absmach/s0/modules/wmbus/wmbus.kicad_pcb

## KiCad design modules/wmbus/wmbus.kicad_pcb (2026-07-27)

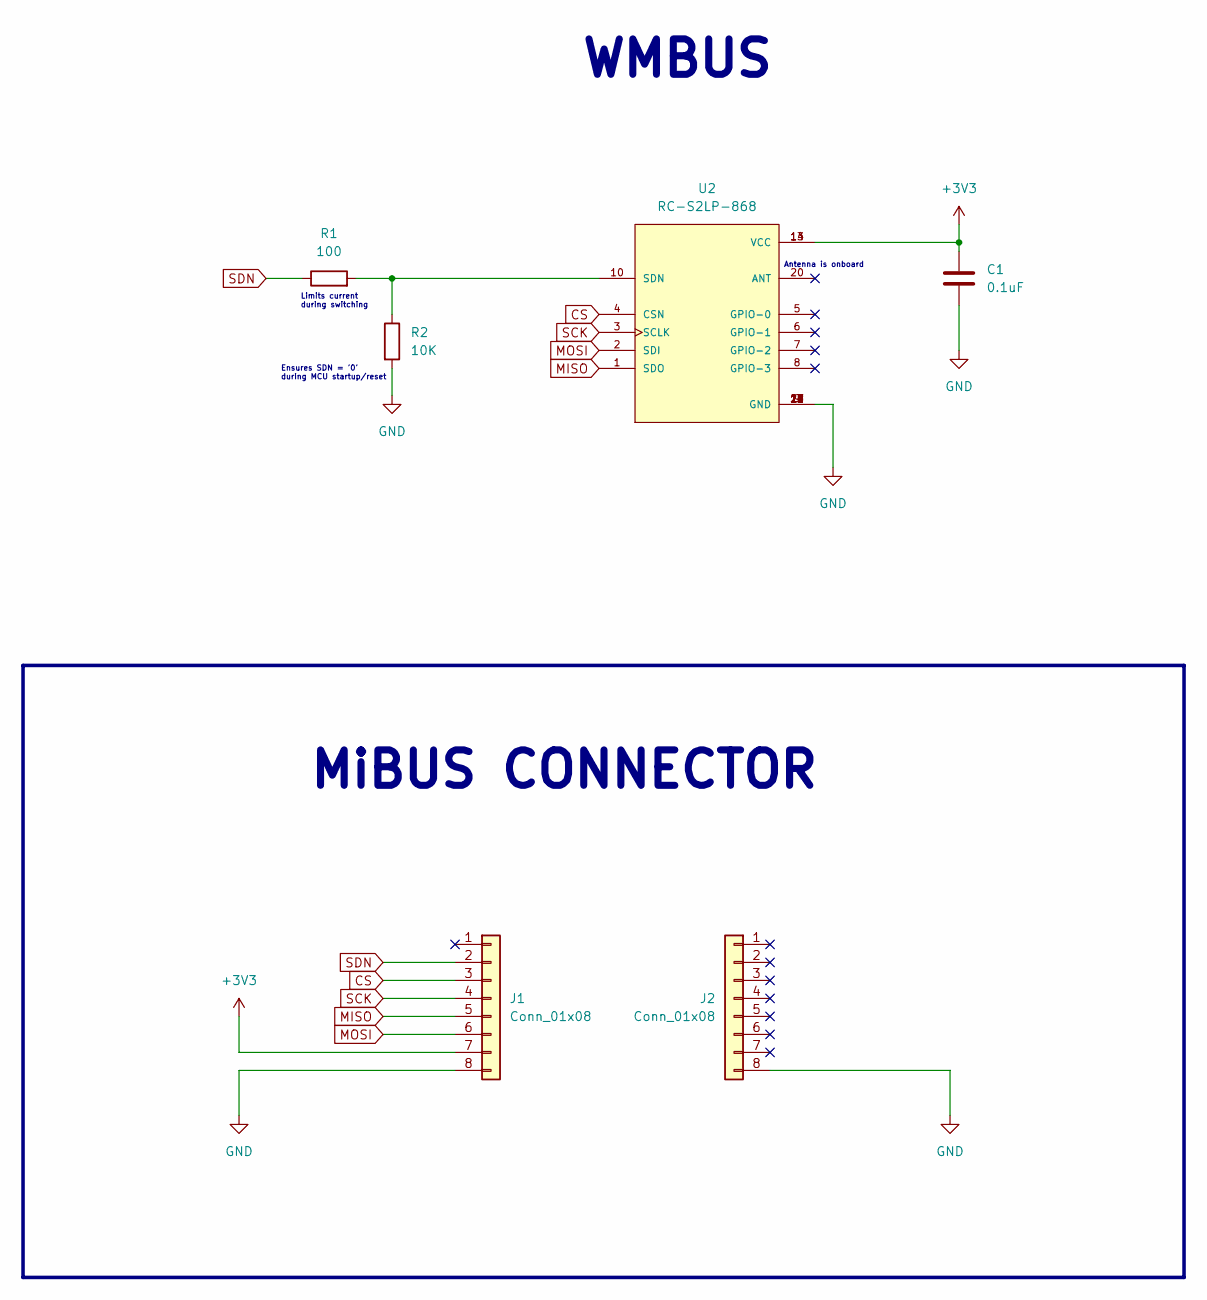
[picture p1: schematic wmbus.kicad_sch, A0 - WMBUS Module]

Parts:
C1: 0.1uF; C_0805_2012Metric; JLCPCB C49678
J1, J2: Conn_01x08; PinHeader_1x08_P2.54mm_Vertical; JLCPCB C492407
R1: 100; R_0805_2012Metric; JLCPCB C17408
R2: 10K; R_0805_2012Metric; JLCPCB C17414
U2: RC-S2LP-868; PARTREV 1.6; DigiKey_Part_Number 3206-RC-S2LP-868TR-ND

Connections:
+3V3: C1.1, J1.7, U2.13 (VCC), U2.14 (VCC)
CS: J1.3, U2.4 (CSN)
GND: C1.2, J1.8, J2.8, R2.2, U2.9 (GND), U2.11 (GND), U2.12 (GND), U2.15 (GND), U2.16 (GND), U2.17 (GND), U2.18 (GND), U2.19 (GND), U2.21 (GND)
MISO: J1.5, U2.1 (SDO)
MOSI: J1.6, U2.2 (SDI)
unnamed: R1.2, R2.1, U2.10 (SDN)
SCK: J1.4, U2.3 (SCLK)
SDN: J1.2, R1.1

Notes on the sheet:
WMBUS
Ensures SDN = '0' during MCU startup/reset
MiBUS CONNECTOR
Limits current during switching
Antenna is onboard

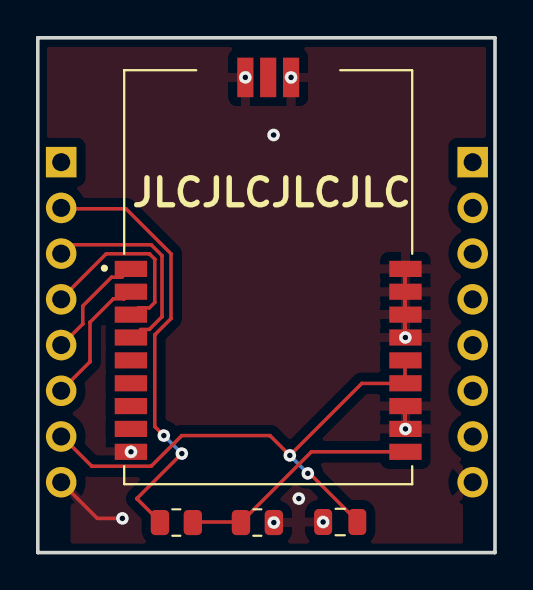
[picture p2: board wmbus.kicad_pcb from above]

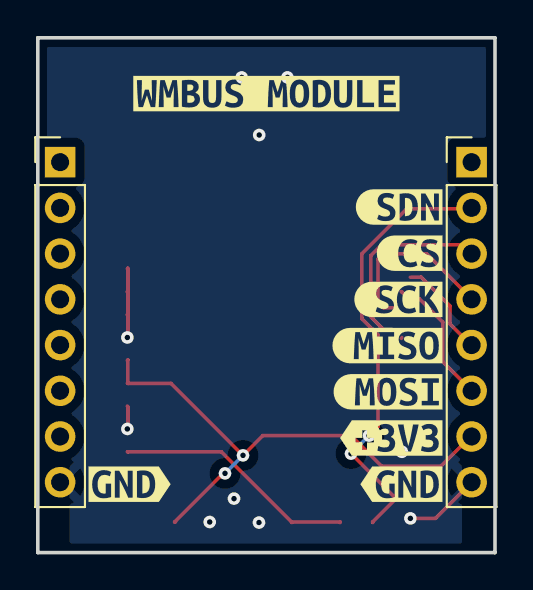
[picture p3: board wmbus.kicad_pcb from below]

Board: 2 copper layers, 25.4 x 28.6 mm, 15 parts (11 on the bottom side), 8 nets.

Other parts of the board:
kibuzzard-6A563B7D: G***; kibuzzard-6A563B7D
kibuzzard-6A563B31: G***; kibuzzard-6A563B31
kibuzzard-6A563B41: G***; kibuzzard-6A563B41
kibuzzard-6A563B50: G***; kibuzzard-6A563B50
kibuzzard-6A563B65: G***; kibuzzard-6A563B65
kibuzzard-6A563B71: G***; kibuzzard-6A563B71
kibuzzard-6A563B88: G***; kibuzzard-6A563B88
kibuzzard-6A563B96: G***; kibuzzard-6A563B96
kibuzzard-6A563BEF: G***; kibuzzard-6A563BEF
