absmach/s0/modules/sim7080g/sim7080g.kicad_pcb

## KiCad design modules/sim7080g/sim7080g.kicad_pcb (2026-07-27)

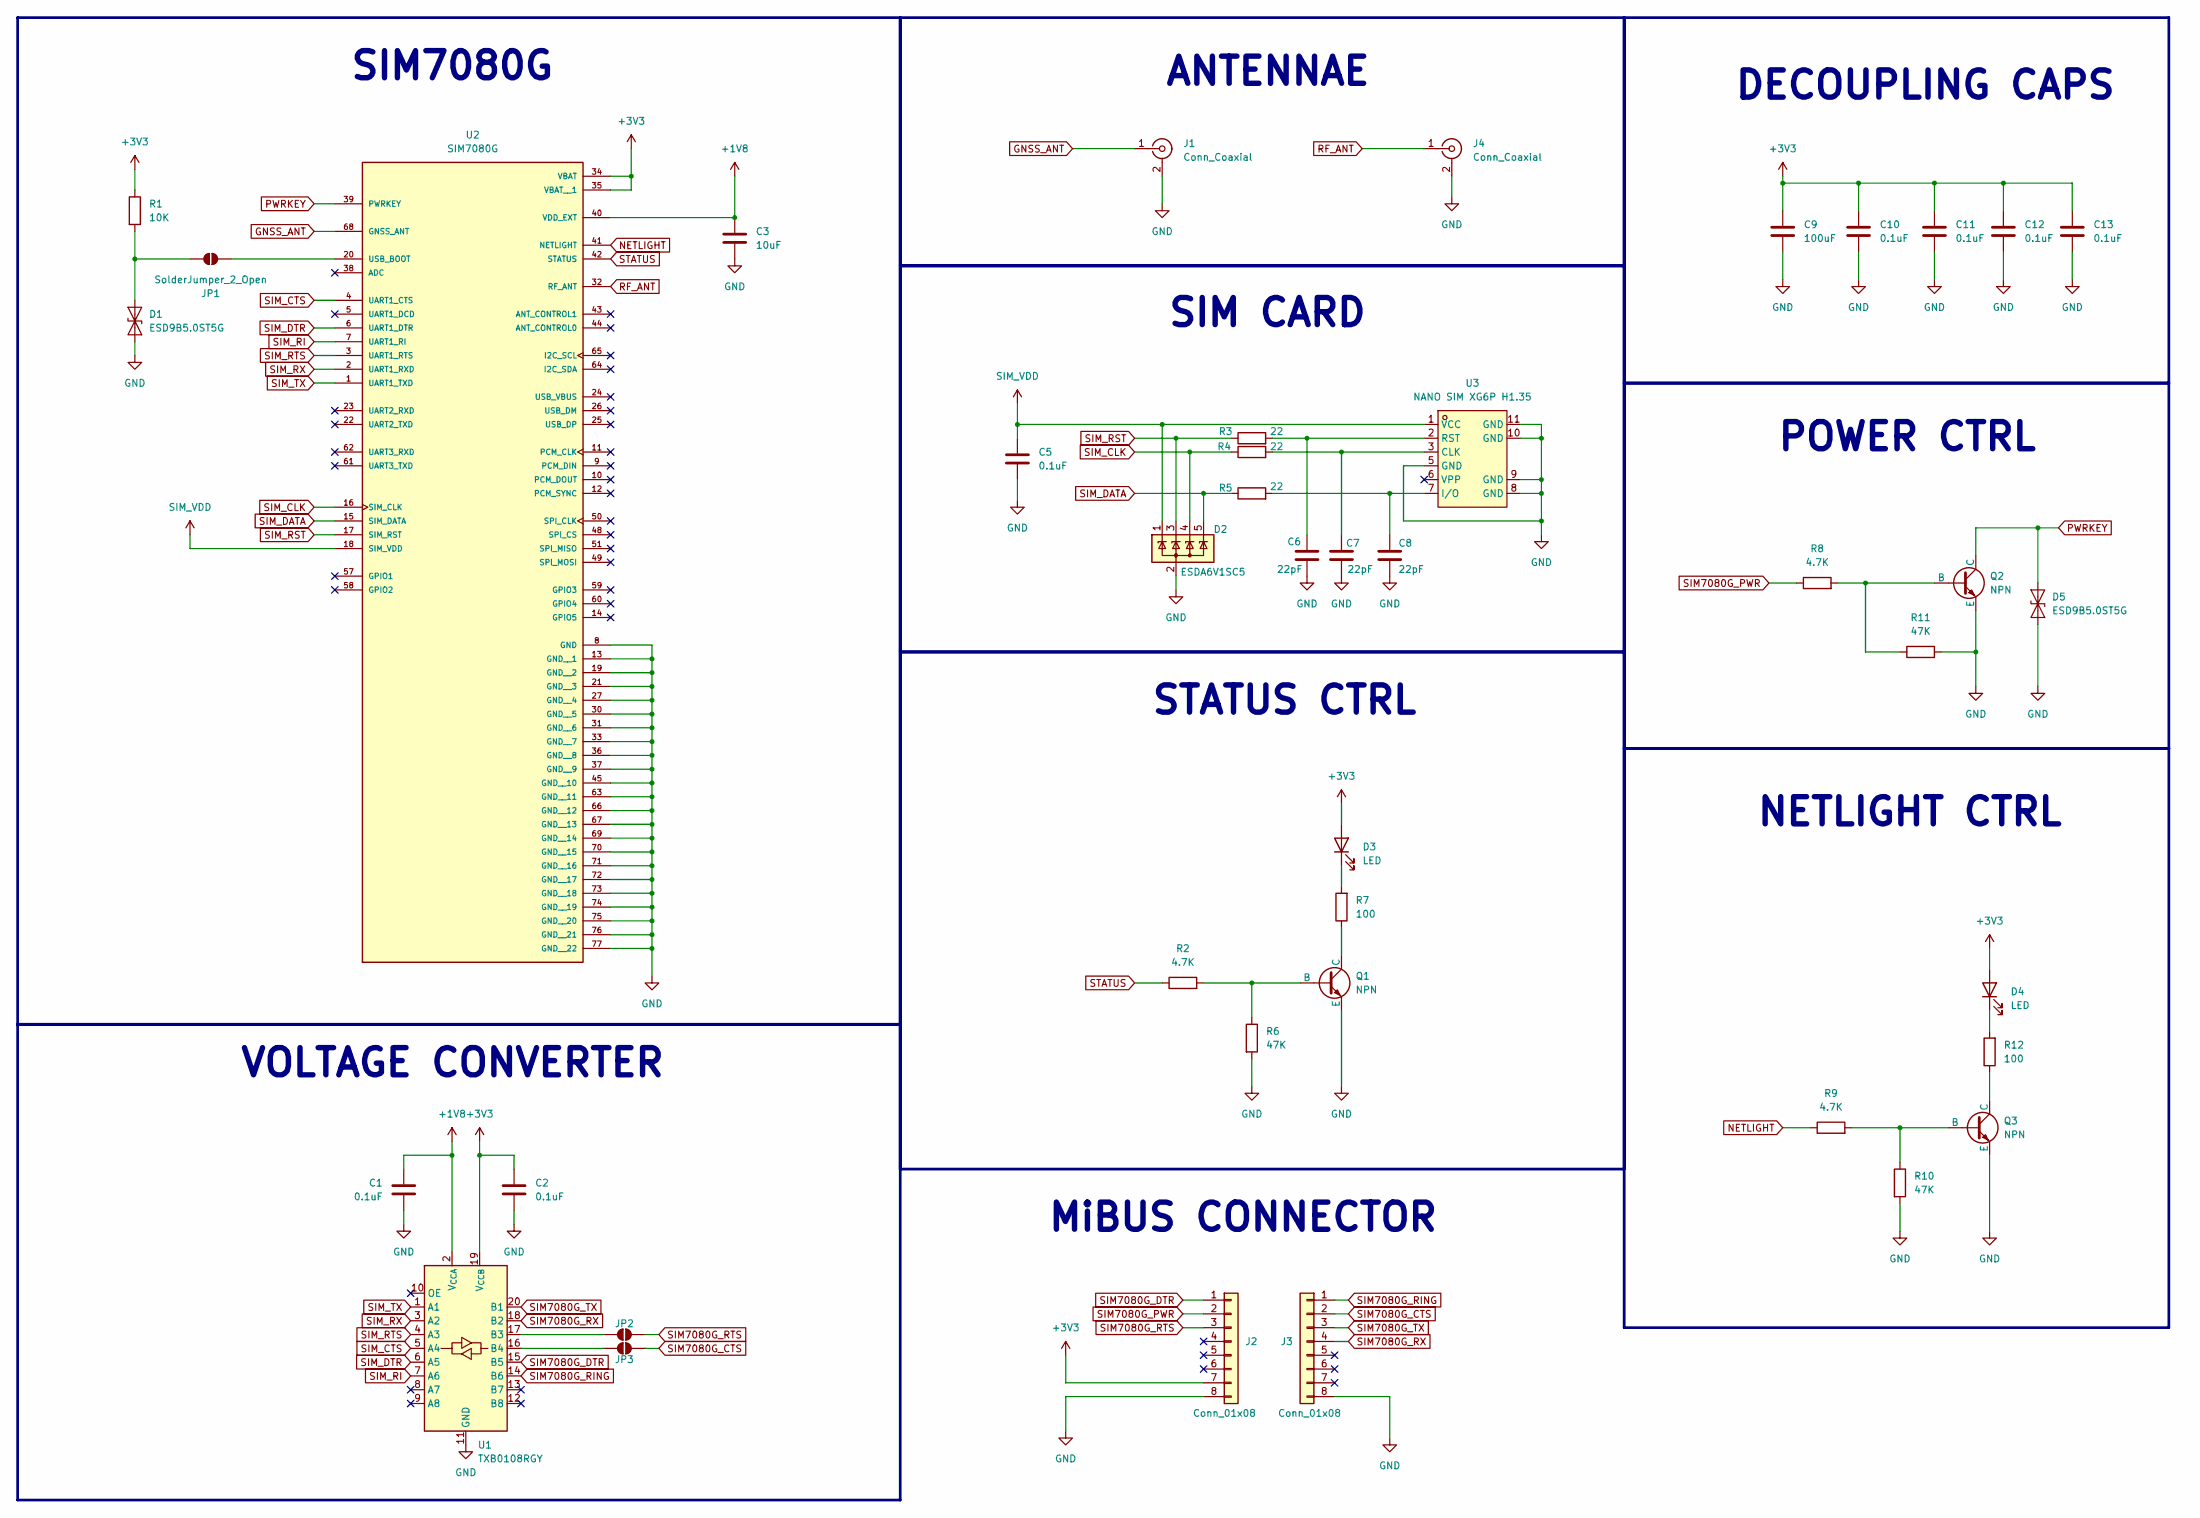
[picture p4: schematic sim7080g.kicad_sch, A0 - SIM7080G Module]

Parts:
C1, C2, C5, C10, C11, C12, C13: 0.1uF; C_0805_2012Metric; JLCPCB C49678
C3: 10uF; C_0805_2012Metric; JLCPCB C15850
C6, C7, C8: 22pF; C_0805_2012Metric; JLCPCB C1804
C9: 100uF; C_1206_3216Metric; JLCPCB C15008
D1, D5: ESD9B5.0ST5G; D_SOD-923; JLCPCB C111566
D2: ESDA6V1SC5; SOT-23-5; JLCPCB C2935146
D3, D4: LED; LED_0805_2012Metric; JLCPCB C6848499
J1, J4: Conn_Coaxial; U.FL_Hirose_U.FL-R-SMT-1_Vertical; JLCPCB C88373
J2, J3: Conn_01x08; PinHeader_1x08_P2.54mm_Vertical; JLCPCB C492407
JP1, JP2, JP3: SolderJumper_2_Open; SolderJumper-2_P1.3mm_Open_RoundedPad1.0x1.5mm
Q1, Q2, Q3: NPN; SOT-23; JLCPCB C2150
R1: 10K; R_0805_2012Metric; JLCPCB C17414
R2, R8, R9: 4.7K; R_0805_2012Metric; JLCPCB C17673
R3, R4, R5: 22; R_0805_2012Metric; JLCPCB C17561
R6, R10, R11: 47K; R_0805_2012Metric; JLCPCB C17713
R7, R12: 100; R_0805_2012Metric; JLCPCB C17408
U1: TXB0108RGY; Texas_RGY_R-PVQFN-N20_EP2.05x3.05mm; JLCPCB C194701
U2: SIM7080G; PARTREV 1.04; JLCPCB C2943992
U3: NANO SIM XG6P H1.35; SIM-SMD_NANO-SIM; LCSC Part C7529386

Connections:
+1V8: C1.2, C3.2, U1.2 (V_{CCA}), U2.40 (VDD_EXT)
+3V3: C2.2, C9.1, C10.1, C11.1, C12.1, C13.1, D3.2 (A), D4.2 (A), J2.7, R1.1, U1.19 (V_{CCB}), U2.34 (VBAT), U2.35 (VBAT__1)
GND: C1.1, C2.1, C3.1, C5.1, C6.1, C7.1, C8.1, C9.2, C10.2, C11.2, C12.2, C13.2, D1.1 (A1), D2.2 (A), D5.1 (A1), J1.2 (Ext), J2.8, J3.8, J4.2 (Ext), Q1.3 (E), Q2.3 (E), Q3.3 (E), R6.2, R10.2, R11.2, U1.11 (GND), U1.21 (GND), U2.8 (GND), U2.13 (GND__1), U2.19 (GND__2), U2.21 (GND__3), U2.27 (GND__4), U2.30 (GND__5), U2.31 (GND__6), U2.33 (GND__7), U2.36 (GND__8), U2.37 (GND__9), U2.45 (GND__10), U2.63 (GND__11), U2.66 (GND__12), U2.67 (GND__13), U2.69 (GND__14), U2.70 (GND__15), U2.71 (GND__16), U2.72 (GND__17), U2.73 (GND__18), U2.74 (GND__19), U2.75 (GND__20), U2.76 (GND__21), U2.77 (GND__22), U3.5 (GND), U3.8 (GND), U3.9 (GND), U3.10 (GND), U3.11 (GND)
GNSS_ANT: J1.1 (In), U2.68 (GNSS_ANT)
NETLIGHT: R9.1, U2.41 (NETLIGHT)
unnamed: D1.2 (A2), JP1.1 (A), R1.2
unnamed: D3.1 (K), R7.2
unnamed: D4.1 (K), R12.2
unnamed: JP1.2 (B), U2.20 (USB_BOOT)
unnamed: JP2.1 (A), U1.17 (B3)
unnamed: JP3.1 (A), U1.16 (B4)
unnamed: Q1.2 (B), R2.2, R6.1
unnamed: Q1.1 (C), R7.1
unnamed: Q2.2 (B), R8.2, R11.1
unnamed: Q3.2 (B), R9.2, R10.1
unnamed: Q3.1 (C), R12.1
unnamed: C7.2, R4.2, U3.3 (CLK)
unnamed: C8.2, R5.2, U3.7 (I/O)
unnamed: C6.2, R3.2, U3.2 (RST)
PWRKEY: D5.2 (A2), Q2.1 (C), U2.39 (PWRKEY)
RF_ANT: J4.1 (In), U2.32 (RF_ANT)
SIM7080G_CTS: J3.2, JP3.2 (B)
SIM7080G_DTR: J2.1, U1.15 (B5)
SIM7080G_PWR: J2.2, R8.1
SIM7080G_RING: J3.1, U1.14 (B6)
SIM7080G_RTS: J2.3, JP2.2 (B)
SIM7080G_RX: J3.4, U1.18 (B2)
SIM7080G_TX: J3.3, U1.20 (B1)
SIM_CLK: D2.4 (K), R4.1, U2.16 (SIM_CLK)
SIM_CTS: U1.5 (A4), U2.4 (UART1_CTS)
SIM_DATA: D2.5 (K), R5.1, U2.15 (SIM_DATA)
SIM_DTR: U1.6 (A5), U2.6 (UART1_DTR)
SIM_RI: U1.7 (A6), U2.7 (UART1_RI)
SIM_RST: D2.3 (K), R3.1, U2.17 (SIM_RST)
SIM_RTS: U1.4 (A3), U2.3 (UART1_RTS)
SIM_RX: U1.3 (A2), U2.2 (UART1_RXD)
SIM_TX: U1.1 (A1), U2.1 (UART1_TXD)
SIM_VDD: C5.2, D2.1 (K), U2.18 (SIM_VDD), U3.1 (VCC)
STATUS: R2.1, U2.42 (STATUS)

Notes on the sheet:
MiBUS CONNECTOR
SIM CARD
DECOUPLING CAPS
POWER CTRL
SIM7080G
VOLTAGE CONVERTER
ANTENNAE
STATUS CTRL
NETLIGHT CTRL

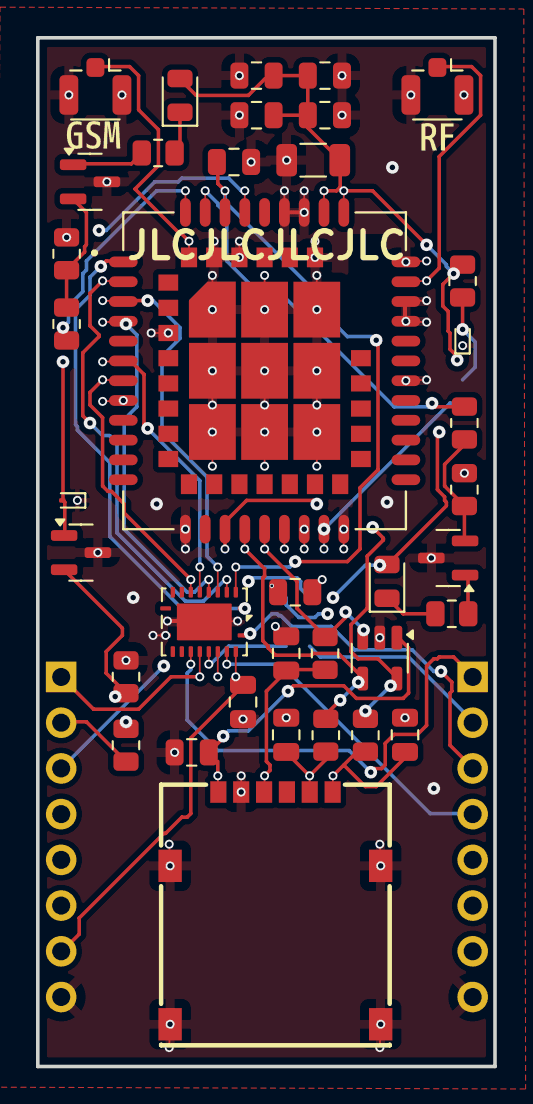
[picture p5: board sim7080g.kicad_pcb from above]

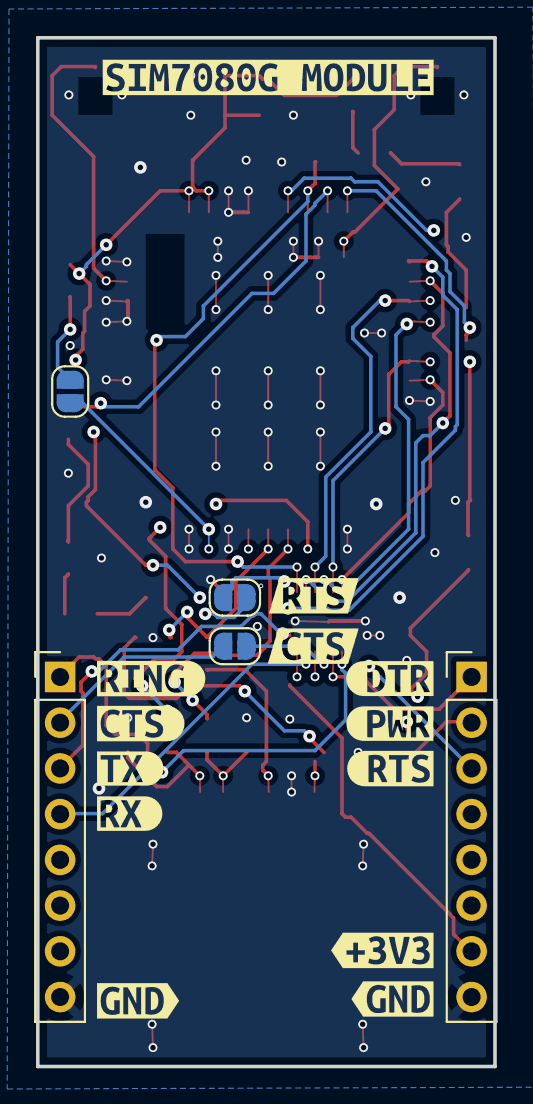
[picture p6: board sim7080g.kicad_pcb from below]

Board: 4 copper layers, 25.4 x 57.2 mm, 57 parts (18 on the bottom side), 39 nets.

Other parts of the board:
kibuzzard-6A58AA2C: G***; kibuzzard-6A58AA2C
kibuzzard-6A58AA08: G***; kibuzzard-6A58AA08
kibuzzard-6A58AA80: G***; kibuzzard-6A58AA80
kibuzzard-6A58AA90: G***; kibuzzard-6A58AA90
kibuzzard-6A58AAA8: G***; kibuzzard-6A58AAA8
kibuzzard-6A58AAC0: G***; kibuzzard-6A58AAC0
kibuzzard-6A58AAD1: G***; kibuzzard-6A58AAD1
kibuzzard-6A58ABB3: G***; kibuzzard-6A58ABB3
kibuzzard-6A58ABC2: G***; kibuzzard-6A58ABC2
kibuzzard-6A58ABCC: G***; kibuzzard-6A58ABCC
kibuzzard-6A58ABD9: G***; kibuzzard-6A58ABD9
kibuzzard-6A58ABE5: G***; kibuzzard-6A58ABE5
kibuzzard-6A58AD62: G***; kibuzzard-6A58AD62
kibuzzard-6A58AD87: G***; kibuzzard-6A58AD87
kibuzzard-6A58ADF5: G***; kibuzzard-6A58ADF5
