absmach/s0/modules/E07400M10S/E07400M10S.kicad_pcb

## KiCad design modules/E07400M10S/E07400M10S.kicad_pcb (2026-07-27)

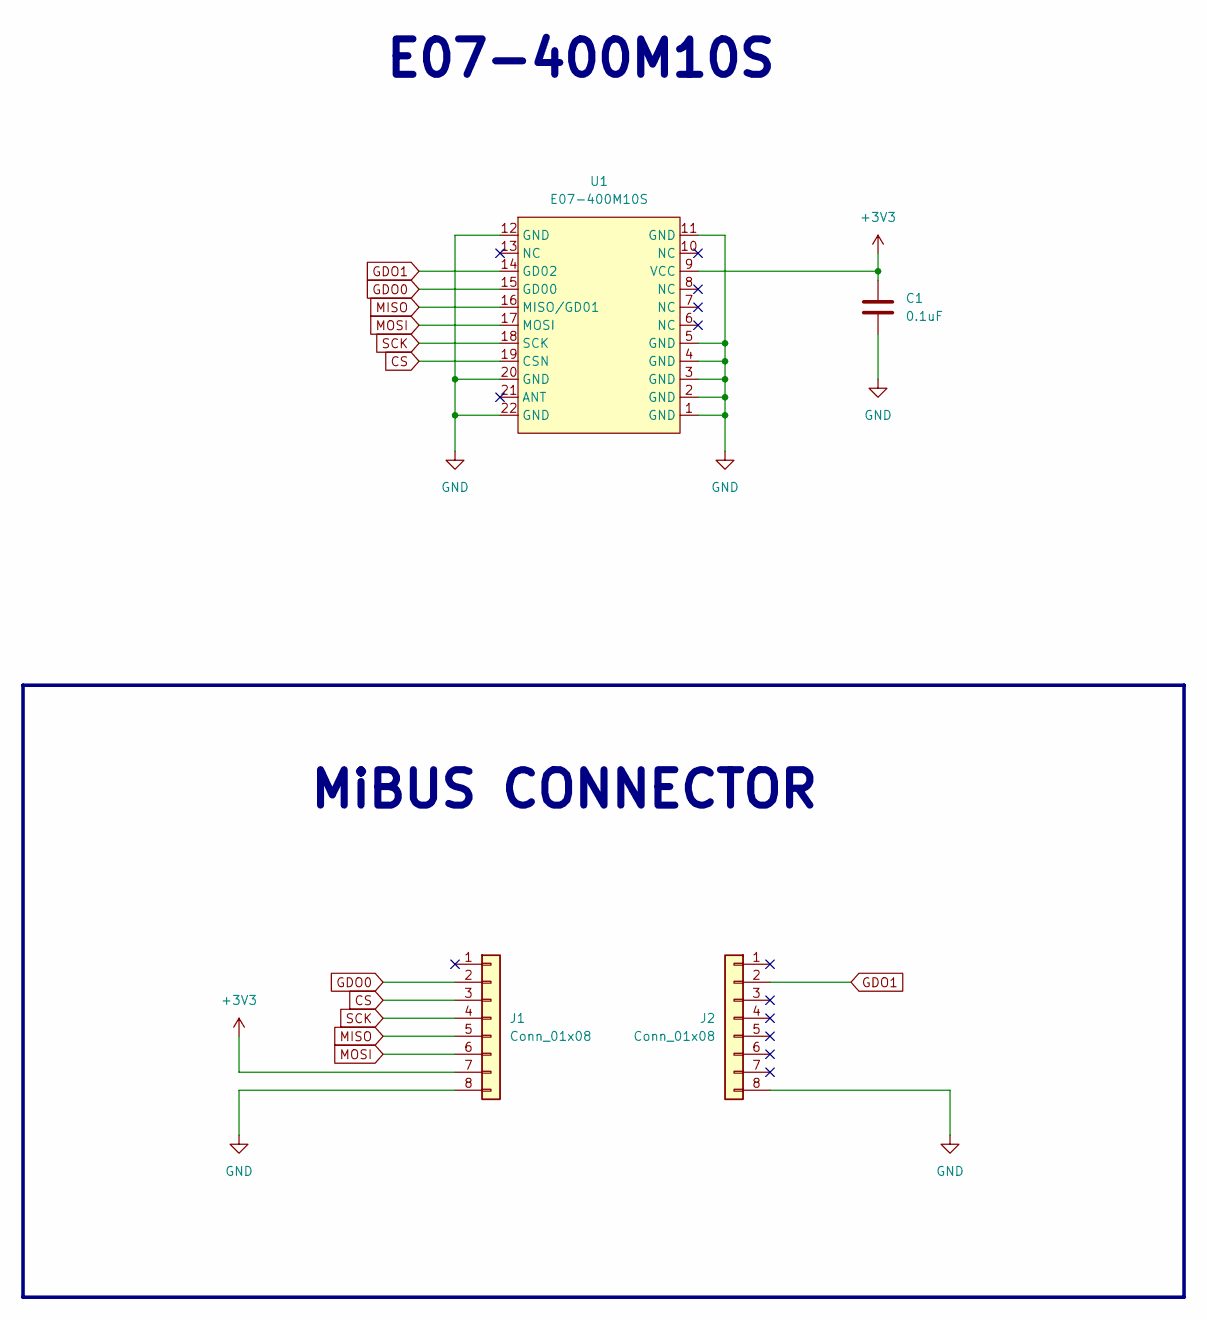
[picture p7: schematic E07400M10S.kicad_sch, A0 - E07-400M10S Module]

Parts:
C1: 0.1uF; C_0805_2012Metric; JLCPCB C49678
J1, J2: Conn_01x08; PinHeader_1x08_P2.54mm_Vertical; JLCPCB C492407
U1: E07-400M10S; C2965513; MPN E07-400M10S; LCSC Part C2965513

Connections:
+3V3: C1.1, J1.7, U1.9 (VCC)
CS: J1.3, U1.19 (CSN)
GDO0: J1.2, U1.15 (GD00)
GDO1: J2.2, U1.14 (GD02)
GND: C1.2, J1.8, J2.8, U1.1 (GND), U1.2 (GND), U1.3 (GND), U1.4 (GND), U1.5 (GND), U1.11 (GND), U1.12 (GND), U1.20 (GND), U1.22 (GND)
MISO: J1.5, U1.16 (MISO/GD01)
MOSI: J1.6, U1.17 (MOSI)
SCK: J1.4, U1.18 (SCK)

Notes on the sheet:
E07-400M10S
MiBUS CONNECTOR

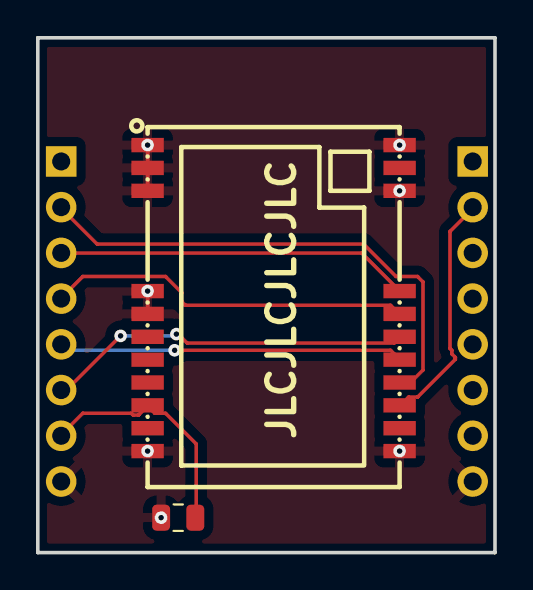
[picture p8: board E07400M10S.kicad_pcb from above]

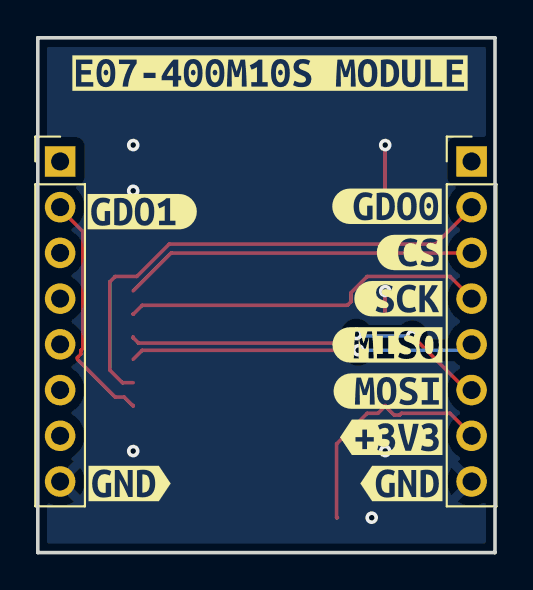
[picture p9: board E07400M10S.kicad_pcb from below]

Board: 2 copper layers, 25.4 x 28.6 mm, 14 parts (12 on the bottom side), 8 nets.

Other parts of the board:
kibuzzard-6A5A4D23: G***; kibuzzard-6A5A4D23
kibuzzard-6A5A4D79: G***; kibuzzard-6A5A4D79
kibuzzard-6A5A4D90: G***; kibuzzard-6A5A4D90
kibuzzard-6A563B7D: G***; kibuzzard-6A563B7D
kibuzzard-6A563B41: G***; kibuzzard-6A563B41
kibuzzard-6A563B50: G***; kibuzzard-6A563B50
kibuzzard-6A563B65: G***; kibuzzard-6A563B65
kibuzzard-6A563B71: G***; kibuzzard-6A563B71
kibuzzard-6A563B88: G***; kibuzzard-6A563B88
kibuzzard-6A563B96: G***; kibuzzard-6A563B96
