absmach/s0/a0-base-board/a0-base-board.kicad_pcb

## KiCad design a0-base-board/a0-base-board.kicad_pcb (2026-07-06)

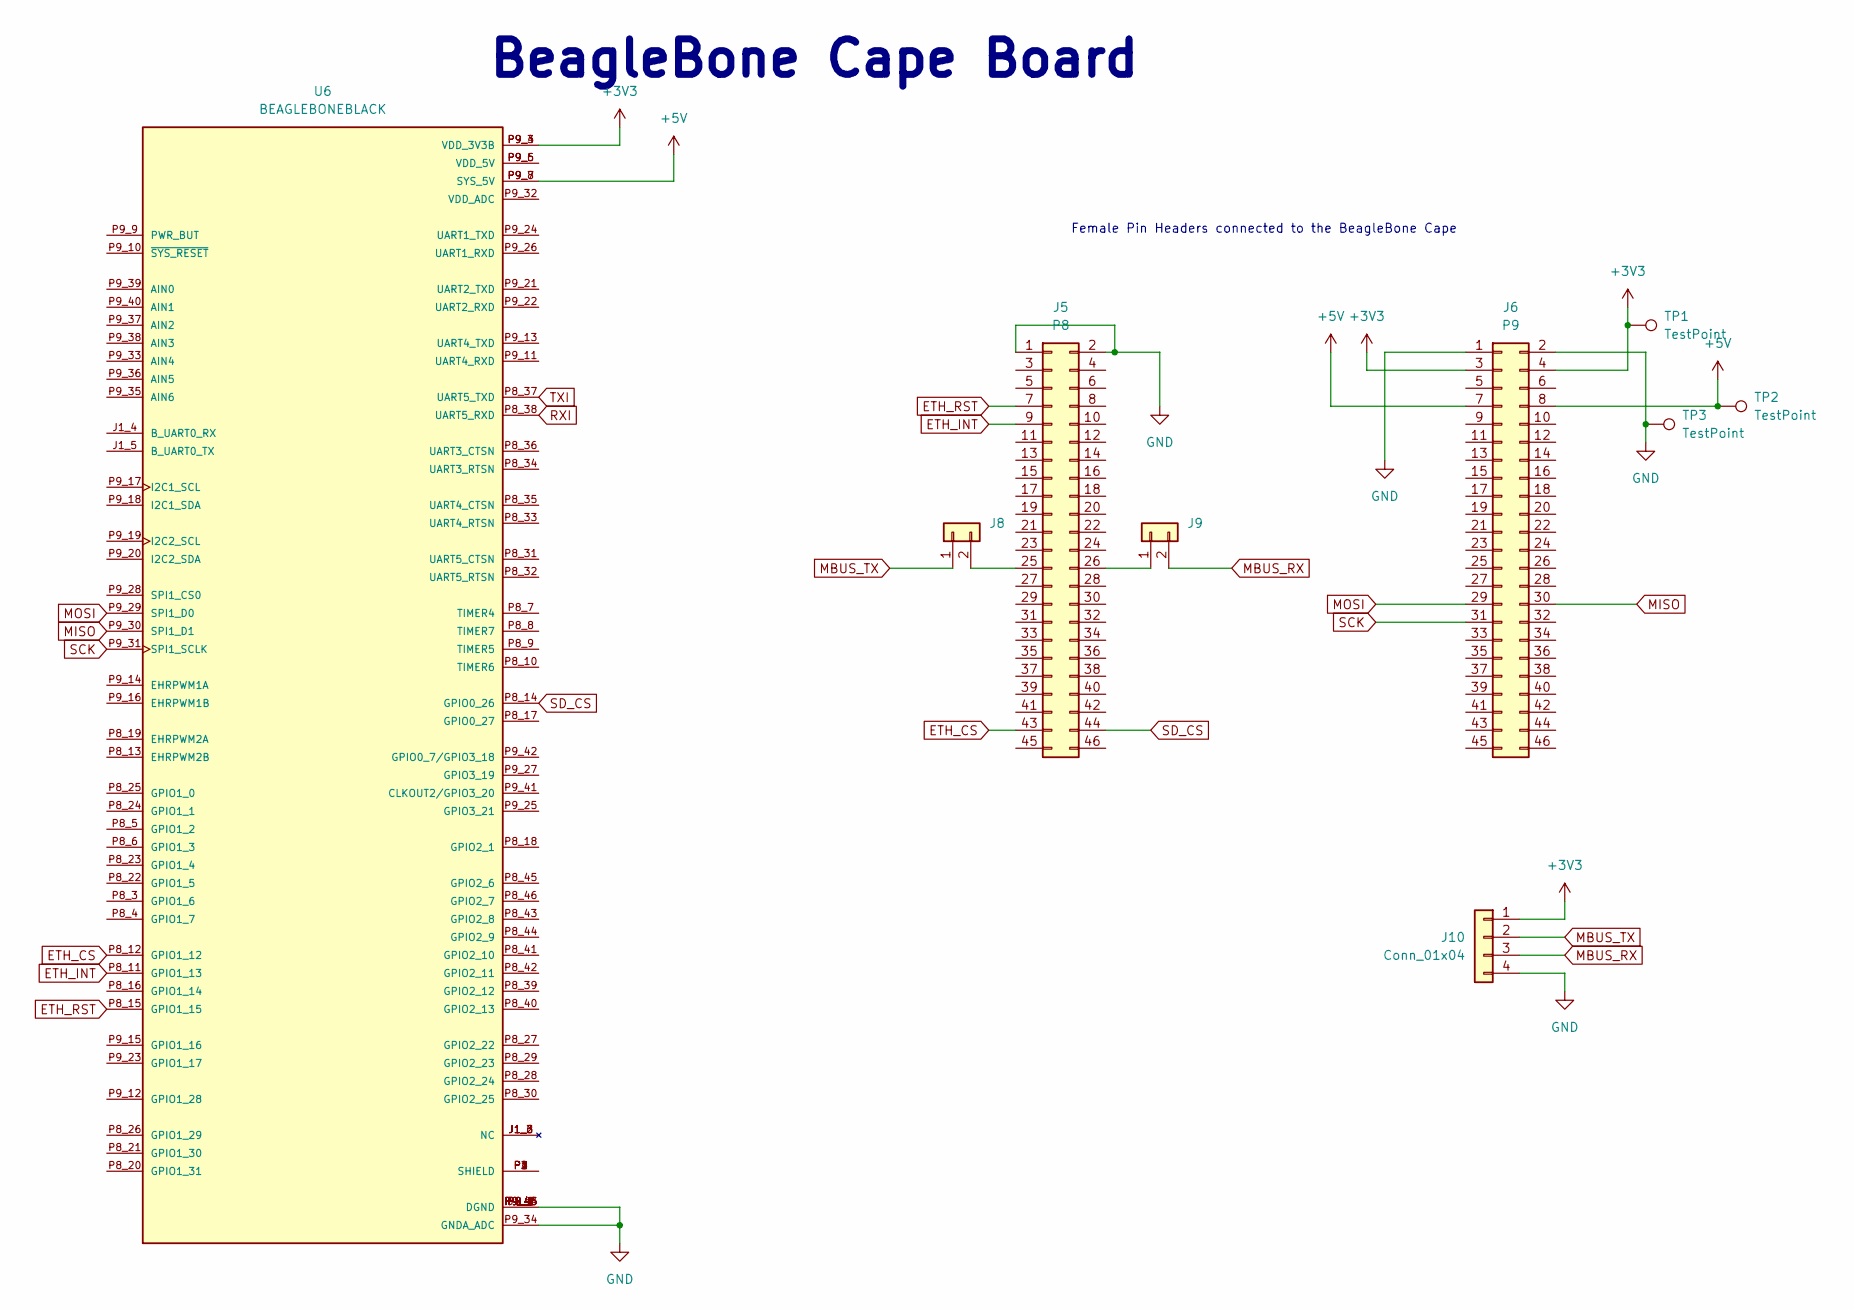
[picture p15: schematic connector.kicad_sch, A0 Base Board]

Parts:
J5: P8; PinSocket_2x23_P2.54mm_Vertical; JLCPCB C27985238
J6: P9; PinSocket_2x23_P2.54mm_Vertical; JLCPCB C27985238
J8, J9: Conn_01x02; PinHeader_1x02_P2.54mm_Vertical; JLCPCB C492401
J10: Conn_01x04; PinHeader_1x04_P2.54mm_Vertical; JLCPCB C2691448
TP1, TP2, TP3: TestPoint; TestPoint_Pad_D1.0mm
U6: BEAGLEBONEBLACK; BB_Cape; PARTREV C

Connections:
+3V3: J6.3, J6.4, J10.1, TP1.1, U6.P9_3 (VDD_3V3B), U6.P9_4 (VDD_3V3B); also elsewhere on the board
ETH_CS: J5.43, U6.P8_12 (GPIO1_12); also elsewhere on the board
ETH_INT: J5.9, U6.P8_11 (GPIO1_13); also elsewhere on the board
ETH_RST: J5.7, U6.P8_15 (GPIO1_15); also elsewhere on the board
FB_5V: J6.7, J6.8, TP2.1, U6.P9_7 (SYS_5V), U6.P9_8 (SYS_5V); also elsewhere on the board
GND: J5.1, J5.2, J6.1, J6.2, J10.4, TP3.1, U6.J1_1 (DGND), U6.P8_1 (DGND), U6.P8_2 (DGND), U6.P9_1 (DGND), U6.P9_2 (DGND), U6.P9_34 (GNDA_ADC), U6.P9_43 (DGND), U6.P9_44 (DGND), U6.P9_45 (DGND), U6.P9_46 (DGND); also elsewhere on the board
MBUS_RX: J9.2, J10.3; also elsewhere on the board
MBUS_TX: J8.1, J10.2; also elsewhere on the board
MISO: J6.30, U6.P9_30 (SPI1_D1); also elsewhere on the board
MOSI: J6.29, U6.P9_29 (SPI1_D0); also elsewhere on the board
unnamed: J5.25, J8.2
unnamed: J5.26, J9.1
unnamed: U6.J1_2 (NC), U6.J1_3 (NC), U6.J1_6 (NC)
unnamed: U6.P1 (SHIELD), U6.P2 (SHIELD), U6.P3 (SHIELD), U6.P4 (SHIELD)
unnamed: U6.P9_5 (VDD_5V), U6.P9_6 (VDD_5V)
SCK: J6.31, U6.P9_31 (SPI1_SCLK); also elsewhere on the board
SD_CS: J5.44, U6.P8_14 (GPIO0_26); also elsewhere on the board

Notes on the sheet:
BeagleBone Cape Board
Female Pin Headers connected to the BeagleBone Cape

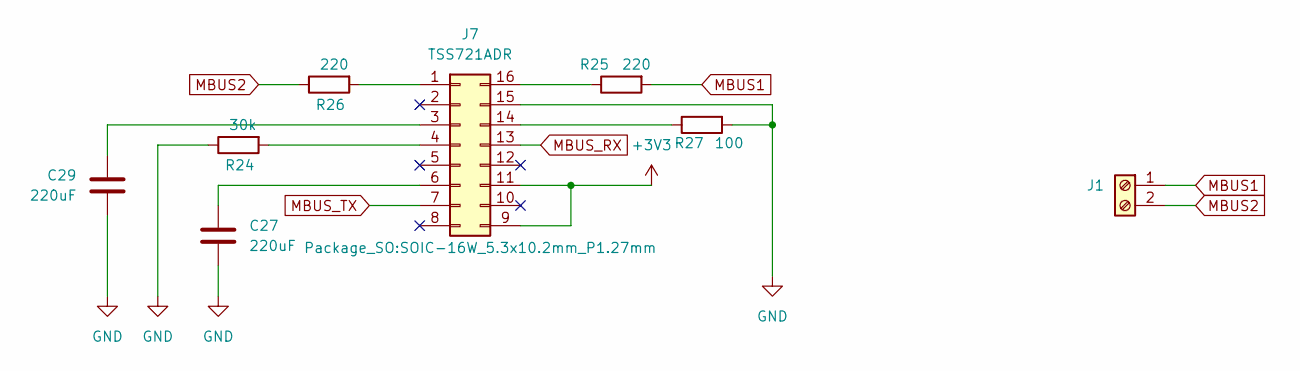
[picture p16: schematic mbus.kicad_sch, A0 Base Board]

Parts:
C27, C29: 220uF; C_1206_3216Metric; JLCPCB C412252
J1: Screw_Terminal_01x02; TerminalBlock_MaiXu_MX126-5.0-02P_1x02_P5.00mm; JLCPCB C8404
J7: TSS721ADR; SOIC-16W_5.3x10.2mm_P1.27mm; JLCPCB C34958
R24: 30k; R_0805_2012Metric_Pad1.20x1.40mm_HandSolder; JLCPCB C17621
R25, R26: 220; R_0805_2012Metric_Pad1.20x1.40mm_HandSolder; JLCPCB C17557
R27: 100; R_0805_2012Metric_Pad1.20x1.40mm_HandSolder; JLCPCB C17408

Connections:
+3V3: J7.9, J7.11; also elsewhere on the board
GND: C27.2, C29.2, J7.15, R24.1, R27.2; also elsewhere on the board
MBUS1: J1.1, R25.2
MBUS2: J1.2, R26.1
MBUS_RX: J7.13; also elsewhere on the board
MBUS_TX: J7.7; also elsewhere on the board
unnamed: J7.1, R26.2
unnamed: C29.1, J7.3
unnamed: J7.4, R24.2
unnamed: C27.1, J7.6
unnamed: J7.14, R27.1
unnamed: J7.16, R25.1

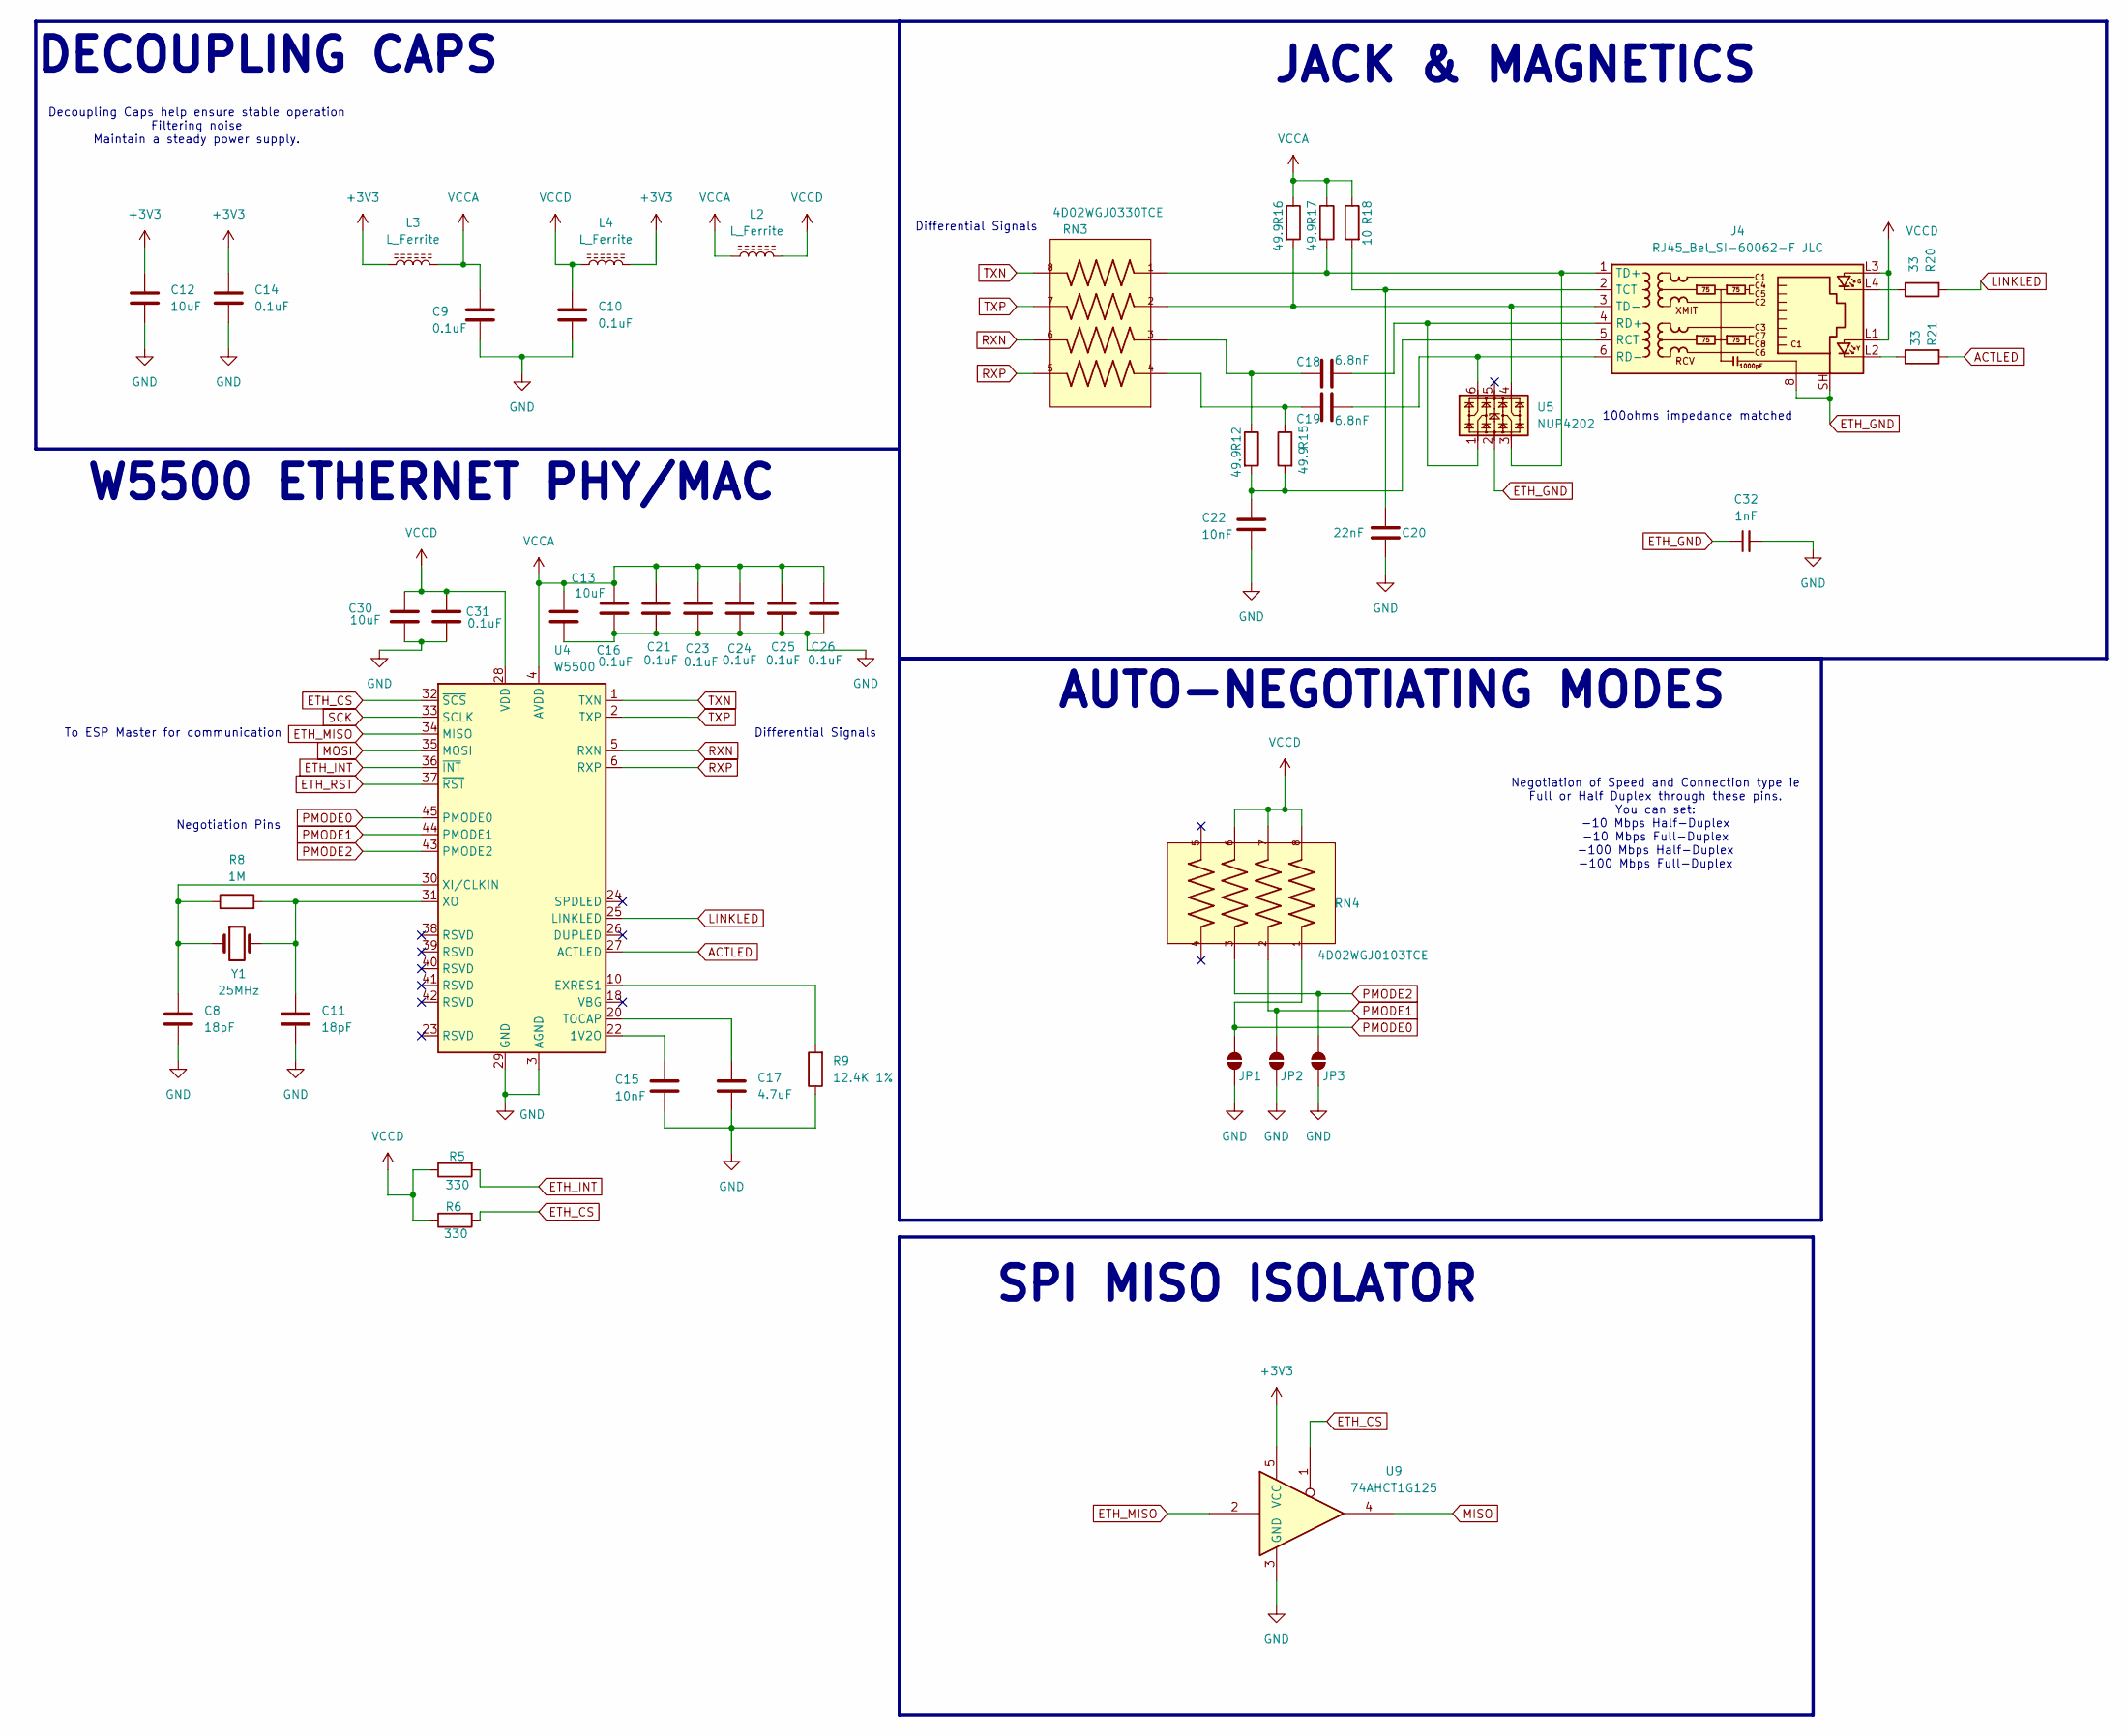
[picture p17: schematic ethernet.kicad_sch, A0 Base Board]

Parts:
C8, C11: 18pF; C_0805_2012Metric_Pad1.18x1.45mm_HandSolder; JLCPCB C1797
C9, C10, C14, C16, C21, C23, C24, C25, C26, C31: 0.1uF; C_0805_2012Metric_Pad1.18x1.45mm_HandSolder; JLCPCB C1711
C12, C13, C30: 10uF; C_0805_2012Metric; JLCPCB C1713
C15, C22: 10nF; C_0805_2012Metric_Pad1.18x1.45mm_HandSolder; JLCPCB C1710
C17: 4.7uF; C_0805_2012Metric_Pad1.18x1.45mm_HandSolder; JLCPCB C1746
C18, C19: 6.8nF; C_0805_2012Metric_Pad1.18x1.45mm_HandSolder; JLCPCB C1755
C20: 22nF; C_0805_2012Metric_Pad1.18x1.45mm_HandSolder; JLCPCB C1729
C32: 1nF; C_0805_2012Metric_Pad1.18x1.45mm_HandSolder; JLCPCB C1791
J4: RJ45_Bel_SI-60062-F JLC; RJ45_Bel_SI-60062-F; JLCPCB C34677
JP1, JP2, JP3: SolderJumper_2_Open; SolderJumper-2_P1.3mm_Open_RoundedPad1.0x1.5mm
L2, L3, L4: L_Ferrite; L_0805_2012Metric; JLCPCB C12631
R5, R6: 330; R_0805_2012Metric_Pad1.20x1.40mm_HandSolder; JLCPCB C17634
R8: 1M; R_0805_2012Metric_Pad1.20x1.40mm_HandSolder; JLCPCB C17514
R9: 12.4K 1%; R_0805_2012Metric_Pad1.20x1.40mm_HandSolder; JLCPCB C30908
R12, R15, R16, R17: 49.9; R_0805_2012Metric_Pad1.20x1.40mm_HandSolder; JLCPCB C17720
R18: 10; R_0805_2012Metric_Pad1.20x1.40mm_HandSolder; JLCPCB C17415
R20, R21: 33; R_0805_2012Metric_Pad1.20x1.40mm_HandSolder; JLCPCB C17634
RN3: 4D02WGJ0330TCE; R_Array_Convex_4x0603; JLCPCB C102664
RN4: 4D02WGJ0103TCE; R_Array_Convex_4x0603; JLCPCB C29718
U4: W5500; LQFP-48_7x7mm_P0.5mm; JLCPCB C32843
U5: NUP4202; SOT-363_SC-70-6; JLCPCB C21713972
U9: 74AHCT1G125; SOT-23-5_HandSoldering; JLCPCB C7484
Y1: 25MHz; Crystal_SMD_3225-4Pin_3.2x2.5mm; JLCPCB C2925590

Connections:
+3V3: C12.1, C14.1, L3.1, L4.1, U9.5 (VCC); also elsewhere on the board
ACTLED: R21.2, U4.27 (ACTLED)
ETH_CS: R6.2, U4.32 (~SCS), U9.1; also elsewhere on the board
ETH_GND: C32.1, J4.8, J4.SH, U5.2
ETH_INT: R5.2, U4.36 (~INT); also elsewhere on the board
ETH_MISO: U4.34 (MISO), U9.2
ETH_RST: U4.37 (~RST); also elsewhere on the board
GND: C8.2, C9.2, C10.2, C11.2, C12.2, C13.2, C14.2, C15.2, C16.2, C17.2, C20.1, C21.2, C22.2, C23.2, C24.2, C25.2, C26.2, C30.2, C31.2, C32.2, JP1.1 (A), JP2.1 (A), JP3.1 (A), R9.1, U4.3 (AGND), U4.9 (AGND), U4.14 (AGND), U4.16 (AGND), U4.19 (AGND), U4.29 (GND), U4.48 (AGND), U9.3 (GND); also elsewhere on the board
LINKLED: R20.2, U4.25 (LINKLED)
MISO: U9.4; also elsewhere on the board
MOSI: U4.35 (MOSI); also elsewhere on the board
unnamed: C18.1, R12.1, RN3.3
unnamed: C19.1, R15.1, RN3.4
unnamed: J4.L2, R21.1
unnamed: J4.L4, R20.1
unnamed: C22.1, J4.5 (RCT), R12.2, R15.2
unnamed: C18.2, J4.4 (RD+), U5.1
unnamed: C19.2, J4.6 (RD-), U5.6
unnamed: C20.2, J4.2 (TCT), R18.2
unnamed: J4.1 (TD+), R17.2, RN3.1, U5.3
unnamed: J4.3 (TD-), R16.2, RN3.2, U5.4
unnamed: C15.1, U4.22 (1V2O)
unnamed: R9.2, U4.10 (EXRES1)
unnamed: C17.1, U4.20 (TOCAP)
unnamed: C8.1, R8.1, U4.30 (XI/CLKIN), Y1.1
unnamed: C11.1, R8.2, U4.31 (XO), Y1.2
PMODE0: JP1.2 (B), RN4.1, U4.45 (PMODE0)
PMODE1: JP2.2 (B), RN4.2, U4.44 (PMODE1)
PMODE2: JP3.2 (B), RN4.3, U4.43 (PMODE2)
RXN: RN3.6, U4.5 (RXN)
RXP: RN3.5, U4.6 (RXP)
SCK: U4.33 (SCLK); also elsewhere on the board
TXN: RN3.8, U4.1 (TXN)
TXP: RN3.7, U4.2 (TXP)
VCCA: C9.1, C13.1, C16.1, C21.1, C23.1, C24.1, C25.1, C26.1, L2.2, L3.2, R16.1, R17.1, R18.1, U4.4 (AVDD), U4.8 (AVDD), U4.11 (AVDD), U4.15 (AVDD), U4.17 (AVDD), U4.21 (AVDD)
VCCD: C10.1, C30.1, C31.1, J4.L1, J4.L3, L2.1, L4.2, R5.1, R6.1, RN4.6, RN4.7, RN4.8, U4.28 (VDD)

Notes on the sheet:
Differential Signals
AUTO-NEGOTIATING MODES
DECOUPLING CAPS
Decoupling Caps help ensure stable operation Filtering noise Maintain a steady power supply.
To ESP Master for communication
W5500 ETHERNET PHY/MAC
Negotiation Pins
SPI MISO ISOLATOR
Negotiation of Speed and Connection type ie Full or Half Duplex through these pins. You can set: -10 Mbps Half-Duplex -10 Mbps Full-Duplex -100 Mbps Half-Duplex -100 Mbps Full-Duplex
100ohms impedance matched
JACK & MAGNETICS

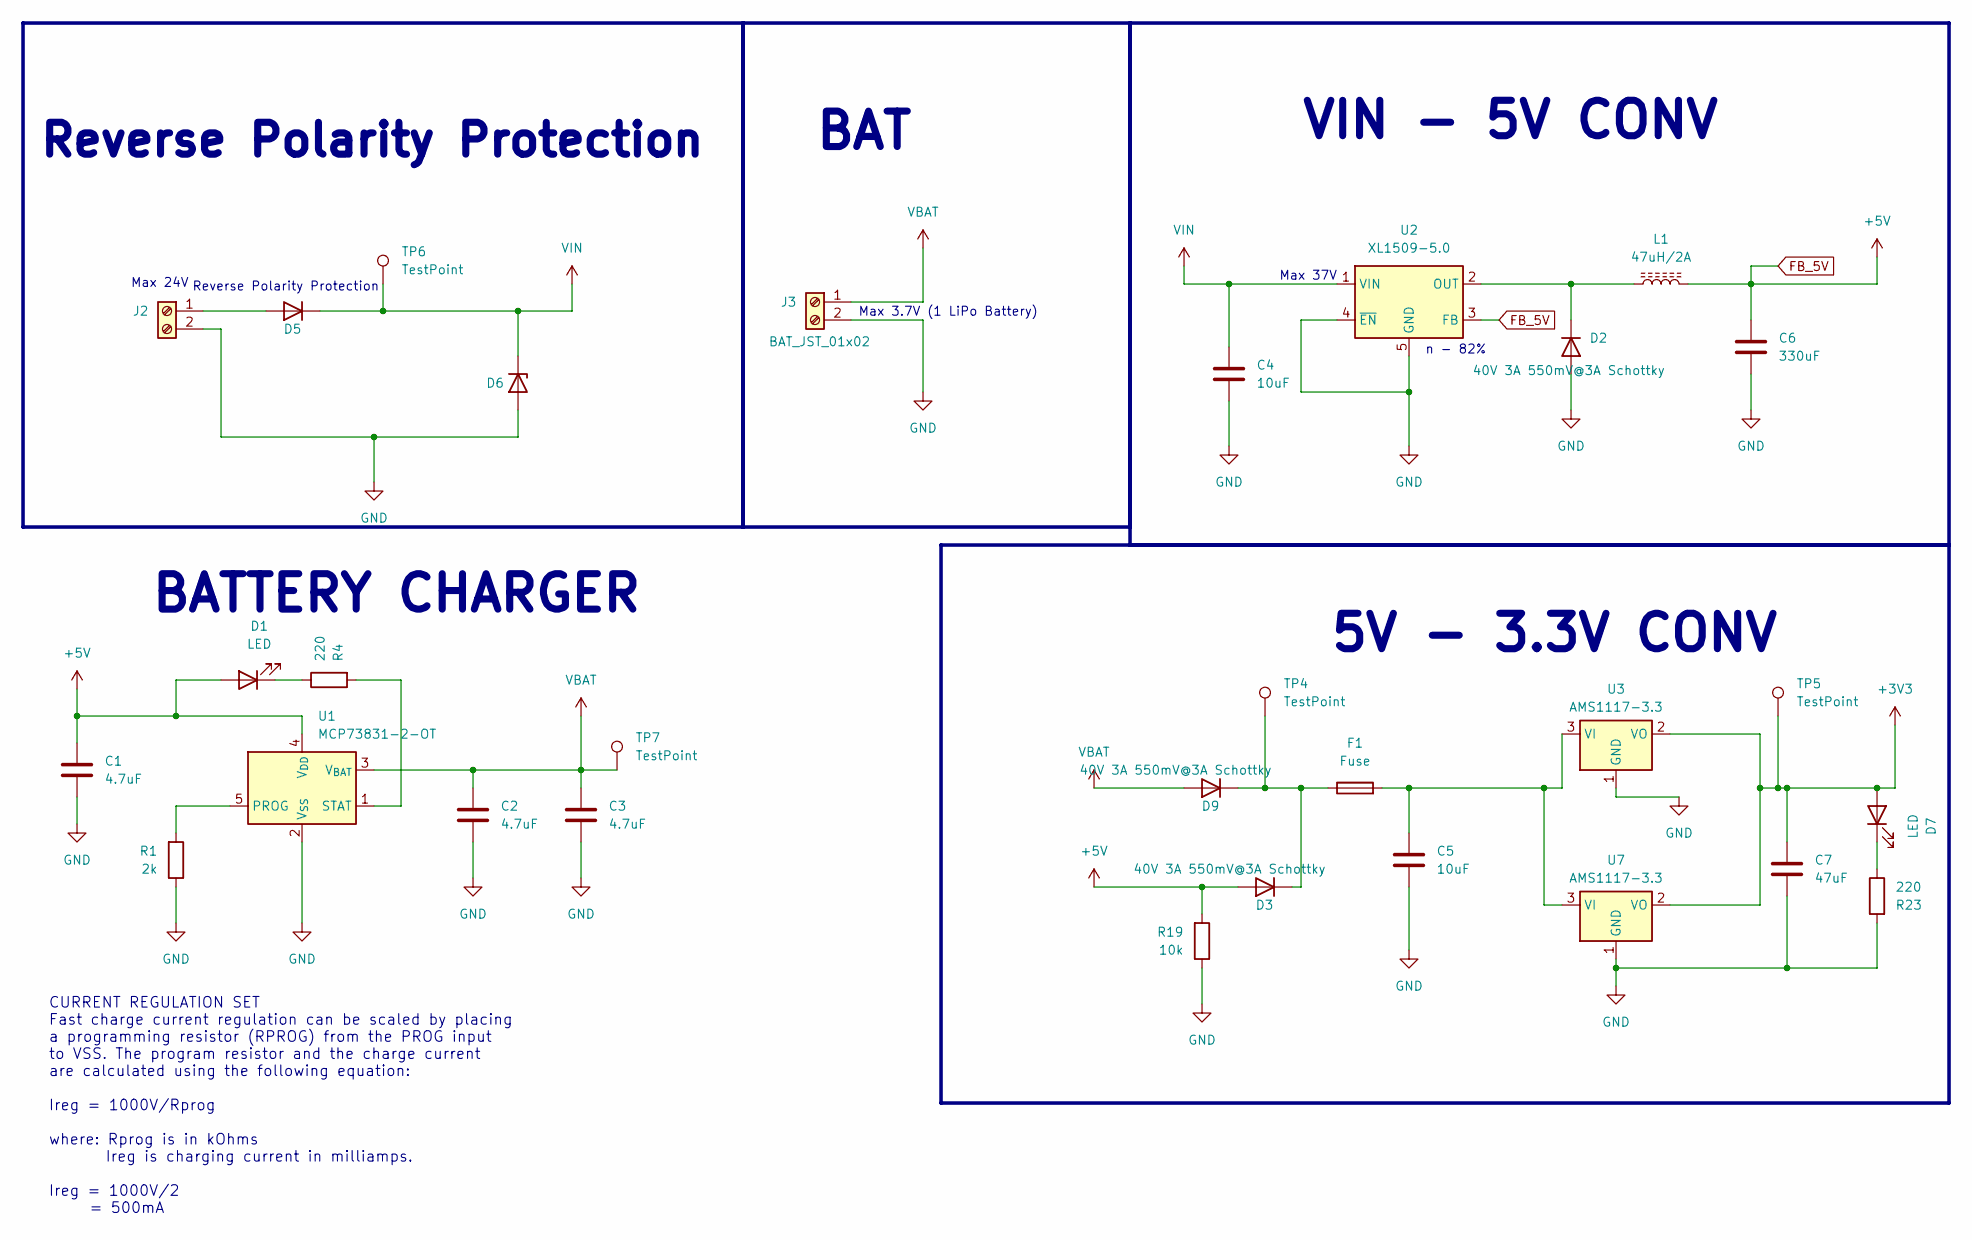
[picture p18: schematic power.kicad_sch, A0 Base Board]

Parts:
C1: 4.7uF; C_0805_2012Metric_Pad1.18x1.45mm_HandSolder; JLCPCB C6119904
C2, C3: 4.7uF; C_0805_2012Metric_Pad1.18x1.45mm_HandSolder; JLCPCB C520074
C4, C5: 10uF; C_0805_2012Metric; JLCPCB C15850
C6: 330uF; C_Elec_8x10.2; JLCPCB C74593
C7: 47uF; C_0805_2012Metric; JLCPCB C6119904
D1, D7: LED; LED_0603_1608Metric; JLCPCB C6848499
D2, D3, D5, D9: 40V 3A 550mV@3A Schottky; D_SMA-SMB_Universal_Handsoldering; JLCPCB C8678
D6: BZV55C27; D_SMA; JLCPCB C688905
F1: Fuse; FUSC3115X66N; JLCPCB C3105
J2: Screw_Terminal_01x02; TerminalBlock_MaiXu_MX126-5.0-02P_1x02_P5.00mm; JLCPCB C8404
J3: BAT_JST_01x02; JST_EH_B2B-EH-A_1x02_P2.50mm_Vertical; JLCPCB C20079
L1: 47uH/2A; L_Chilisin_BMRB00060624; JLCPCB C5189938
R1: 2k; R_0805_2012Metric_Pad1.20x1.40mm_HandSolder; JLCPCB C1359
R4: 220; R_0805_2012Metric_Pad1.20x1.40mm_HandSolder; JLCPCB C17557
R19: 10k; R_0805_2012Metric_Pad1.20x1.40mm_HandSolder; JLCPCB C17414
R23: 220; R_0603_1608Metric; JLCPCB C22962
TP4, TP5, TP6, TP7: TestPoint; TestPoint_Pad_D1.0mm
U1: MCP73831-2-OT; SOT-23-5; JLCPCB C14879
U2: XL1509-5.0; SOIC-8_3.9x4.9mm_P1.27mm; JLCPCB C61063
U3, U7: AMS1117-3.3; SOT-223-3_TabPin2; JLCPCB C6186

Connections:
+3V3: C7.1, D7.2 (A), TP5.1, U3.2 (VO), U7.2 (VO); also elsewhere on the board
FB_5V: C1.1, C6.1, D1.2 (A), D3.2 (A), L1.2, R19.2, U1.4 (V_{DD}), U2.3 (FB); also elsewhere on the board
GND: C1.2, C2.2, C3.2, C4.2, C5.2, C6.2, C7.2, D2.2 (A), D6.2 (A), J2.2, J3.2, R1.1, R19.1, R23.2, U1.2 (V_{SS}), U2.4 (~EN), U2.5 (GND), U2.6 (GND), U2.7 (GND), U2.8 (GND), U3.1 (GND), U7.1 (GND); also elsewhere on the board
unnamed: D1.1 (K), R4.1
unnamed: D2.1 (K), L1.1, U2.2 (OUT)
unnamed: D3.1 (K), D9.1 (K), F1.1, TP4.1
unnamed: D5.2 (A), J2.1
unnamed: D7.1 (K), R23.1
unnamed: R1.2, U1.5 (PROG)
unnamed: R4.2, U1.1 (STAT)
unnamed: C5.1, F1.2, U3.3 (VI), U7.3 (VI)
VBAT: C2.1, C3.1, D9.2 (A), J3.1, TP7.1, U1.3 (V_{BAT})
VIN: C4.1, D5.1 (K), D6.1 (K), TP6.1, U2.1 (VIN)

Notes on the sheet:
Reverse Polarity Protection
Max 3.7V (1 LiPo Battery)
Max 24V
VIN - 5V CONV
BAT
BATTERY CHARGER
CURRENT REGULATION SET Fast charge current regulation can be scaled by placing a programming resistor (RPROG) from the PROG input to VSS. The program resistor and the charge current are calculated using the following equation: Ireg = 1000V/Rprog where: Rprog is in kOhms Ireg is charging current in 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
5V - 3.3V CONV
Max 37V
n - 82%
