absmach/s0/a0-base-board/a0-base-board.kicad_pcb

## KiCad design a0-base-board/a0-base-board.kicad_pcb (continued)

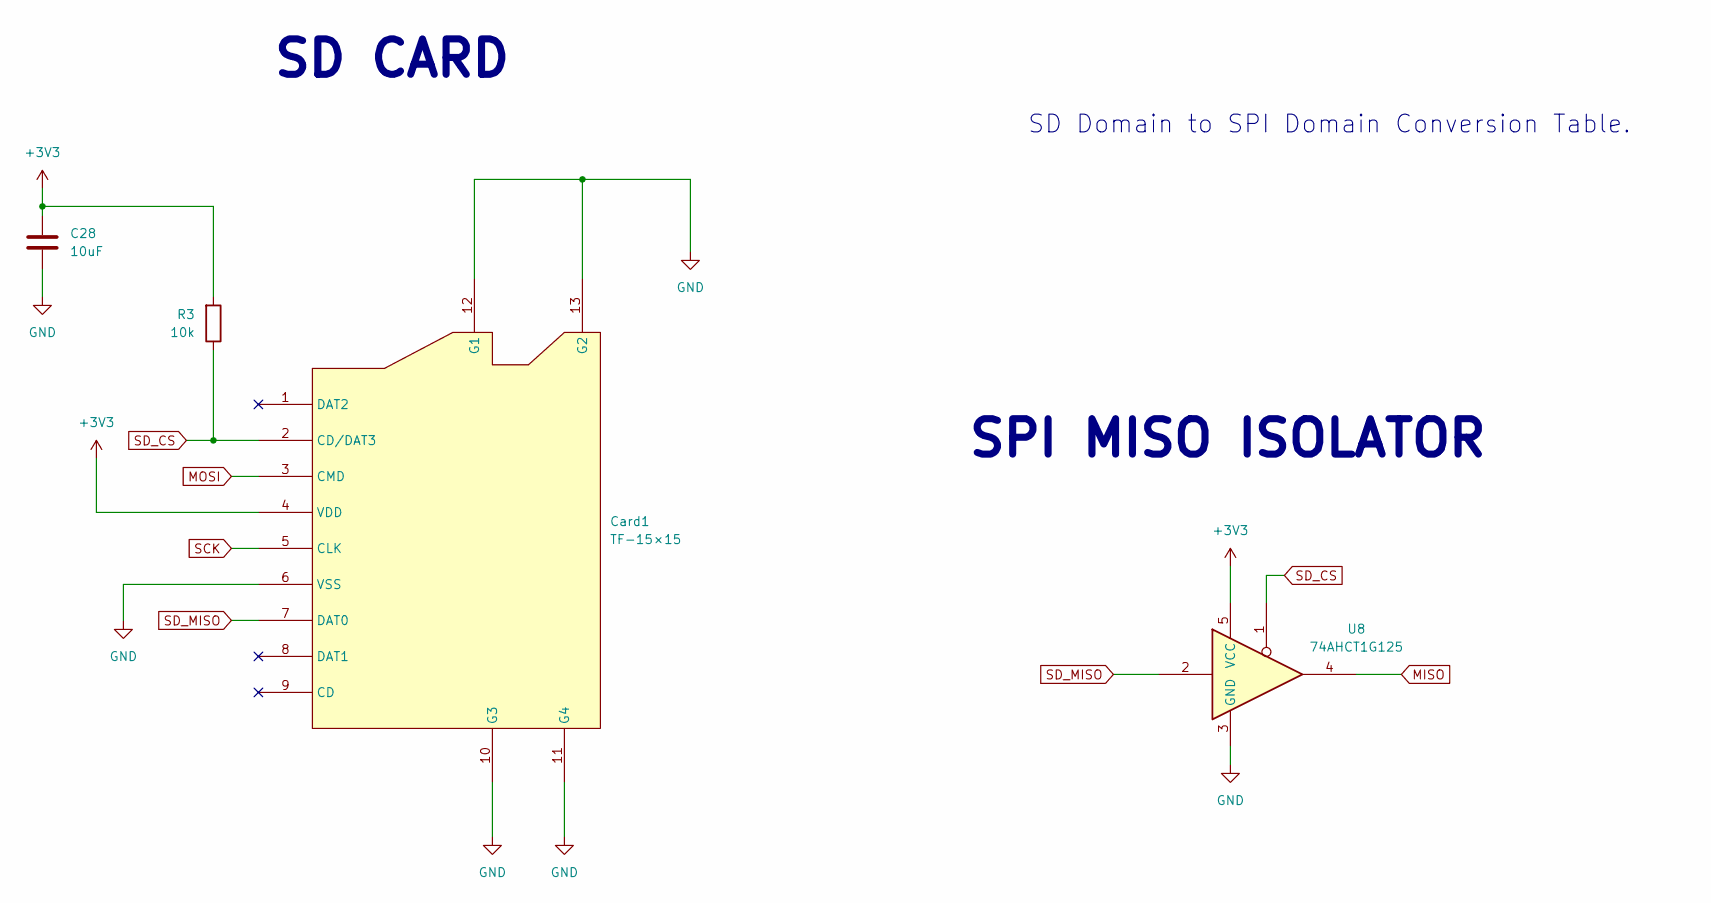
[picture p19: schematic sdcard.kicad_sch, A0 Base Board]

Parts:
C28: 10uF; C_0805_2012Metric; JLCPCB C15850
Card1: TF-15×15; TF-SMD_TF-15-15; JLCPCB C111196
R3: 10k; R_0805_2012Metric_Pad1.20x1.40mm_HandSolder; JLCPCB C17414
U8: 74AHCT1G125; SOT-23-5_HandSoldering; JLCPCB C7484

Connections:
+3V3: C28.1, Card1.4 (VDD), R3.2, U8.5 (VCC); also elsewhere on the board
GND: C28.2, Card1.6 (VSS), Card1.10 (G3), Card1.11 (G4), Card1.12 (G1), Card1.13 (G2), U8.3 (GND); also elsewhere on the board
MISO: U8.4; also elsewhere on the board
MOSI: Card1.3 (CMD); also elsewhere on the board
SCK: Card1.5 (CLK); also elsewhere on the board
SD_CS: Card1.2 (CD/DAT3), R3.1, U8.1; also elsewhere on the board
SD_MISO: Card1.7 (DAT0), U8.2

Notes on the sheet:
SD CARD
SPI MISO ISOLATOR
SD Domain to SPI Domain Conversion Table.

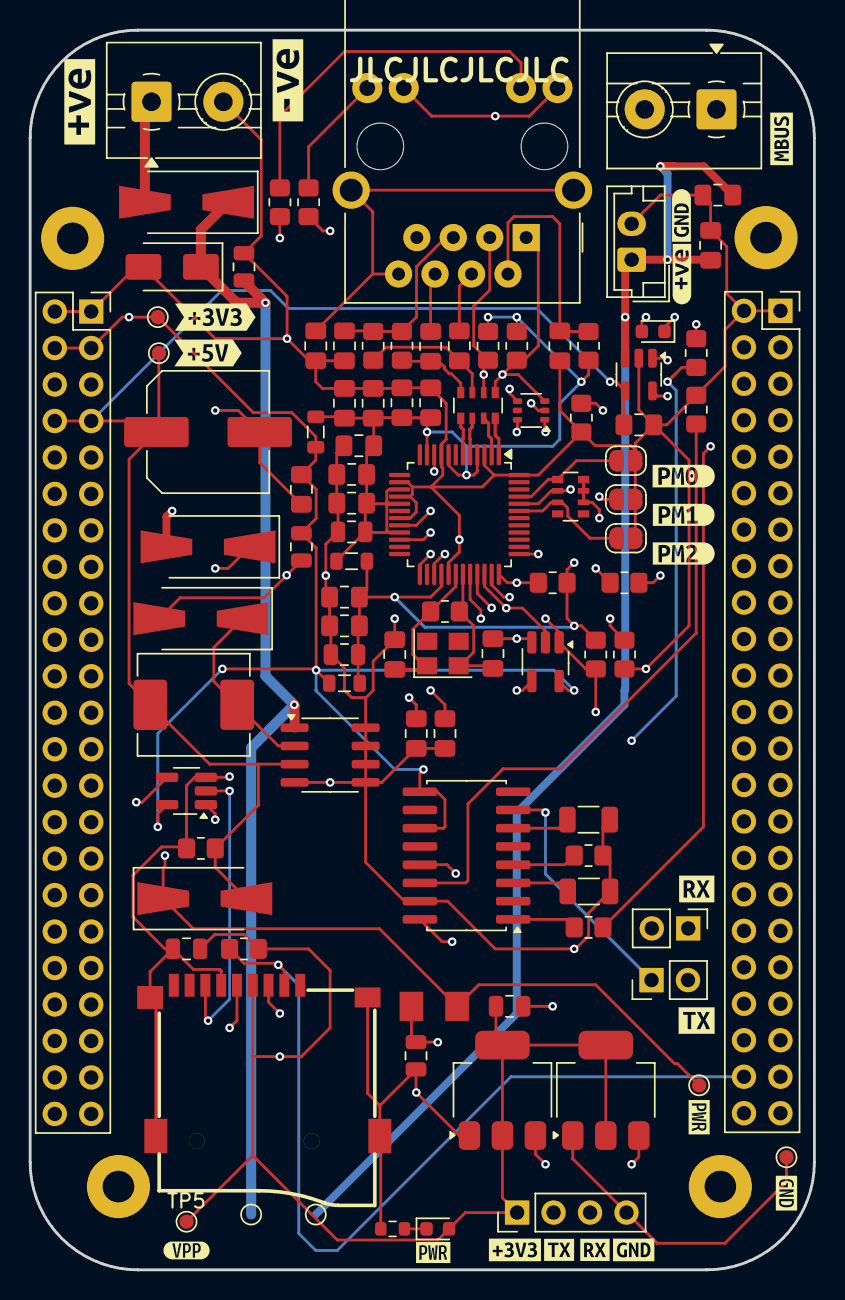
[picture p20: board a0-base-board.kicad_pcb from above]

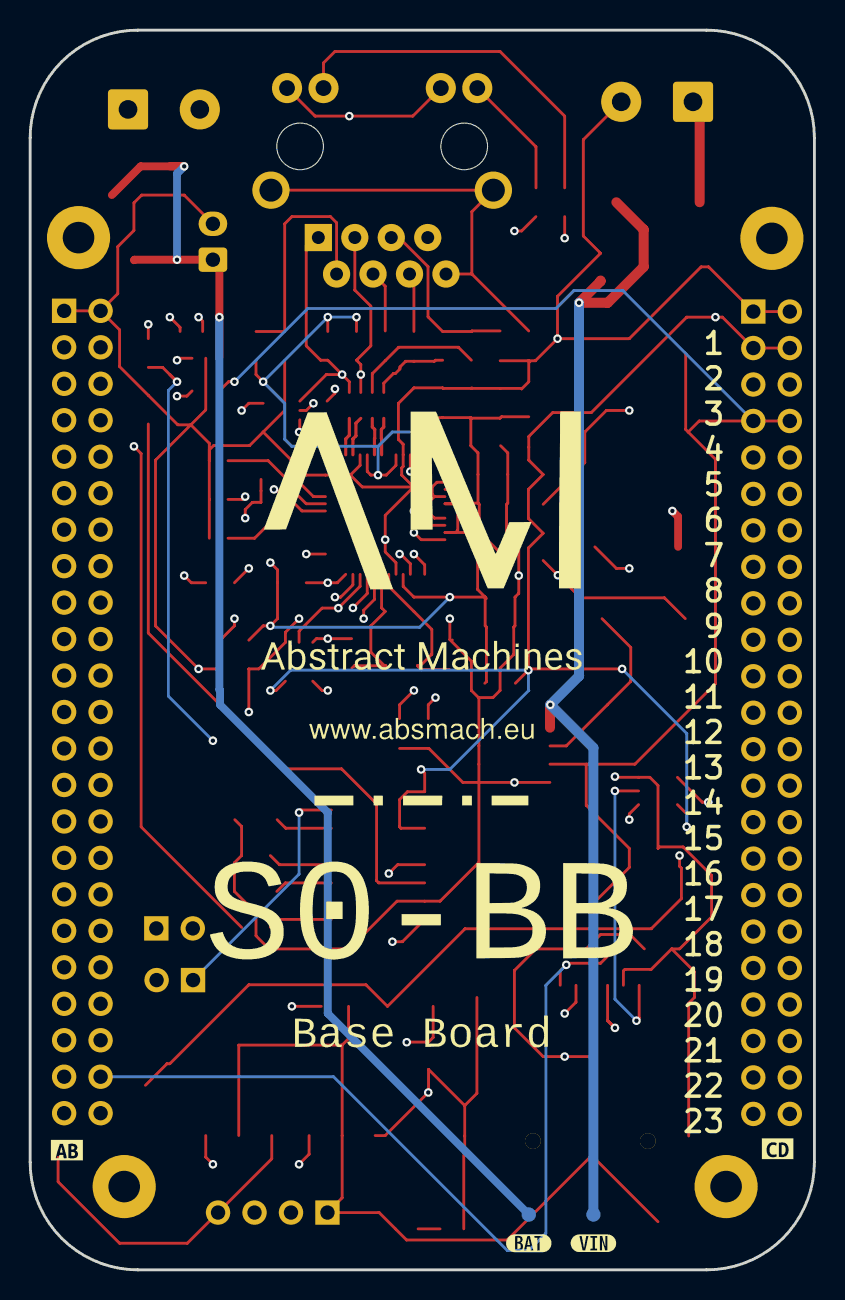
[picture p21: board a0-base-board.kicad_pcb from below]

Board: 4 copper layers, 54.6 x 86.3 mm, 124 parts (4 on the bottom side), 61 nets.

Other parts of the board:
REF1, REF2, REF3, REF4: MountingHole_2.2mm_M2_Pad
kibuzzard-67D30BA5: G***; kibuzzard-67D30BA5
kibuzzard-67D30BB5: G***; kibuzzard-67D30BB5
kibuzzard-67D30C9E: G***; kibuzzard-67D30C9E
kibuzzard-67D30C33: G***; kibuzzard-67D30C33
kibuzzard-67D30CE3: G***; kibuzzard-67D30CE3
kibuzzard-67D30CF0: G***; kibuzzard-67D30CF0
kibuzzard-67D30CFC: G***; kibuzzard-67D30CFC
kibuzzard-67ED70B8: G***; kibuzzard-67ED70B8
kibuzzard-67ED70F9: G***; kibuzzard-67ED70F9
kibuzzard-67ED74E9: G***; kibuzzard-67ED74E9
kibuzzard-682E2406: G***; kibuzzard-682E2406
kibuzzard-6821DD7B: G***; kibuzzard-6821DD7B
kibuzzard-6821DED1: G***; kibuzzard-6821DED1
kibuzzard-6821DEDD: G***; kibuzzard-6821DEDD
kibuzzard-6877D2F1: G***; kibuzzard-6877D2F1
kibuzzard-6877D33F: G***; kibuzzard-6877D33F
kibuzzard-6877D35D: G***; kibuzzard-6877D35D
kibuzzard-682327D1: G***; kibuzzard-682327D1
kibuzzard-683033BA: G***; kibuzzard-683033BA
kibuzzard-683033DE: G***; kibuzzard-683033DE
kibuzzard-6823277D: G***; kibuzzard-6823277D
kibuzzard-68232762: G***; kibuzzard-68232762
kibuzzard-68232771: G***; kibuzzard-68232771
kibuzzard-68232786: G***; kibuzzard-68232786
